clementtttttttt/osprey_dev/README.md

# Osprey_dev

ROM and SIO program for the Osprey Portable Computing Unit

ROM contains a graphical operating system 
SIO contains code for handling commands from the cpu
