clementtttttttt/osprey_dev/kicad/jlcpcb/production_files/BOM-osprey68.csv

Comment | Designator | Footprint | LCSC | Quantity
100n | C11,C12,C13,C14,C15,C16,C5,C6,C7,C8,C9 | C_0603_1608Metric | C14663 | 11
10u | C4 | C_0603_1608Metric | C19702 | 1
10u | C3 | C_0603_1608Metric | C96446 | 1
16Mhz | Y2 | Crystal_SMD_5032-2Pin_5.0x3.2mm_HandSoldering | C112572 | 1
1N4148W | D1 | D_SOD-123 | C81598 | 1
1k | R1,R2,R3,R4 | R_0603_1608Metric | C21190 | 4
22p | C1,C2 | C_0603_1608Metric | C1653 | 2
74HC245D | U4 | SOIC-20W_7.5x12.8mm_P1.27mm | C5625 | 1
74HC74 | U2 | SO-14_3.9x8.65mm_P1.27mm | C41361407 | 1
AMS1117-3.3 | U12 | SOT-223-3_TabPin2 | C6186 | 1
SN74LVC126APWR-TP | U6 | TSSOP-14_4.4x5mm_P0.65mm | C54561942 | 1
8Mhz | Y1 | Oscillator_DIP-8 |  | 1
VIA1 | U15 | DIP-40_W15.24mm_Socket |  | 1
VIA0 | U11 | DIP-40_W15.24mm_Socket |  | 1
ATmega16A-P | U10 | DIP-40_W15.24mm_Socket |  | 1
128k sram | U9 | SOJ-32_7.62x20.955mm_P1.27mm |  | 1
GAL20V8 | U5 | DIP-24_W7.62mm_Socket |  | 1
MC6809E | U1 | DIP-40_W15.24mm_Socket |  | 1
PS2_USB | J1 | USB_A_Molex_67643_Horizontal |  | 1
28C256 | U3 | DIP_Socket-28_W11.9mm_W12.7mm_W15.24mm_W17.78mm_W18.5mm_3M_228-1277-00-0602J |  | 1
Conn_01x08_Pin | J2 | PinHeader_1x08_P2.54mm_Vertical |  | 1
SN74AHCT16245DGGR | U8 | TSSOP-48_6.1x12.5mm_P0.5mm |  | 1
SW_Push | SW1 | PinHeader_1x02_P2.54mm_Vertical |  | 1
SW_SPDT | SW2 | PinHeader_1x03_P2.54mm_Vertical |  | 1
AVR-ISP-6 | J3 | PinHeader_2x03_P2.54mm_Vertical |  | 1
Conn_01x04_Pin | J4 | PinHeader_1x04_P2.54mm_Vertical |  | 1
SD | J6 | PinHeader_1x06_P2.54mm_Vertical |  | 1
LCD | J8 | PinHeader_1x06_P2.54mm_Vertical |  | 1
I2c | J7 | PinHeader_1x05_P2.54mm_Vertical |  | 1
IS62C256AL | U7 | SOP-28_8.4x18.16mm_P1.27mm |  | 1
