clementtttttttt/osprey_dev/kicad/osprey68.kicad_pcb

## KiCad design kicad/osprey68.kicad_pcb (2026-10-19)

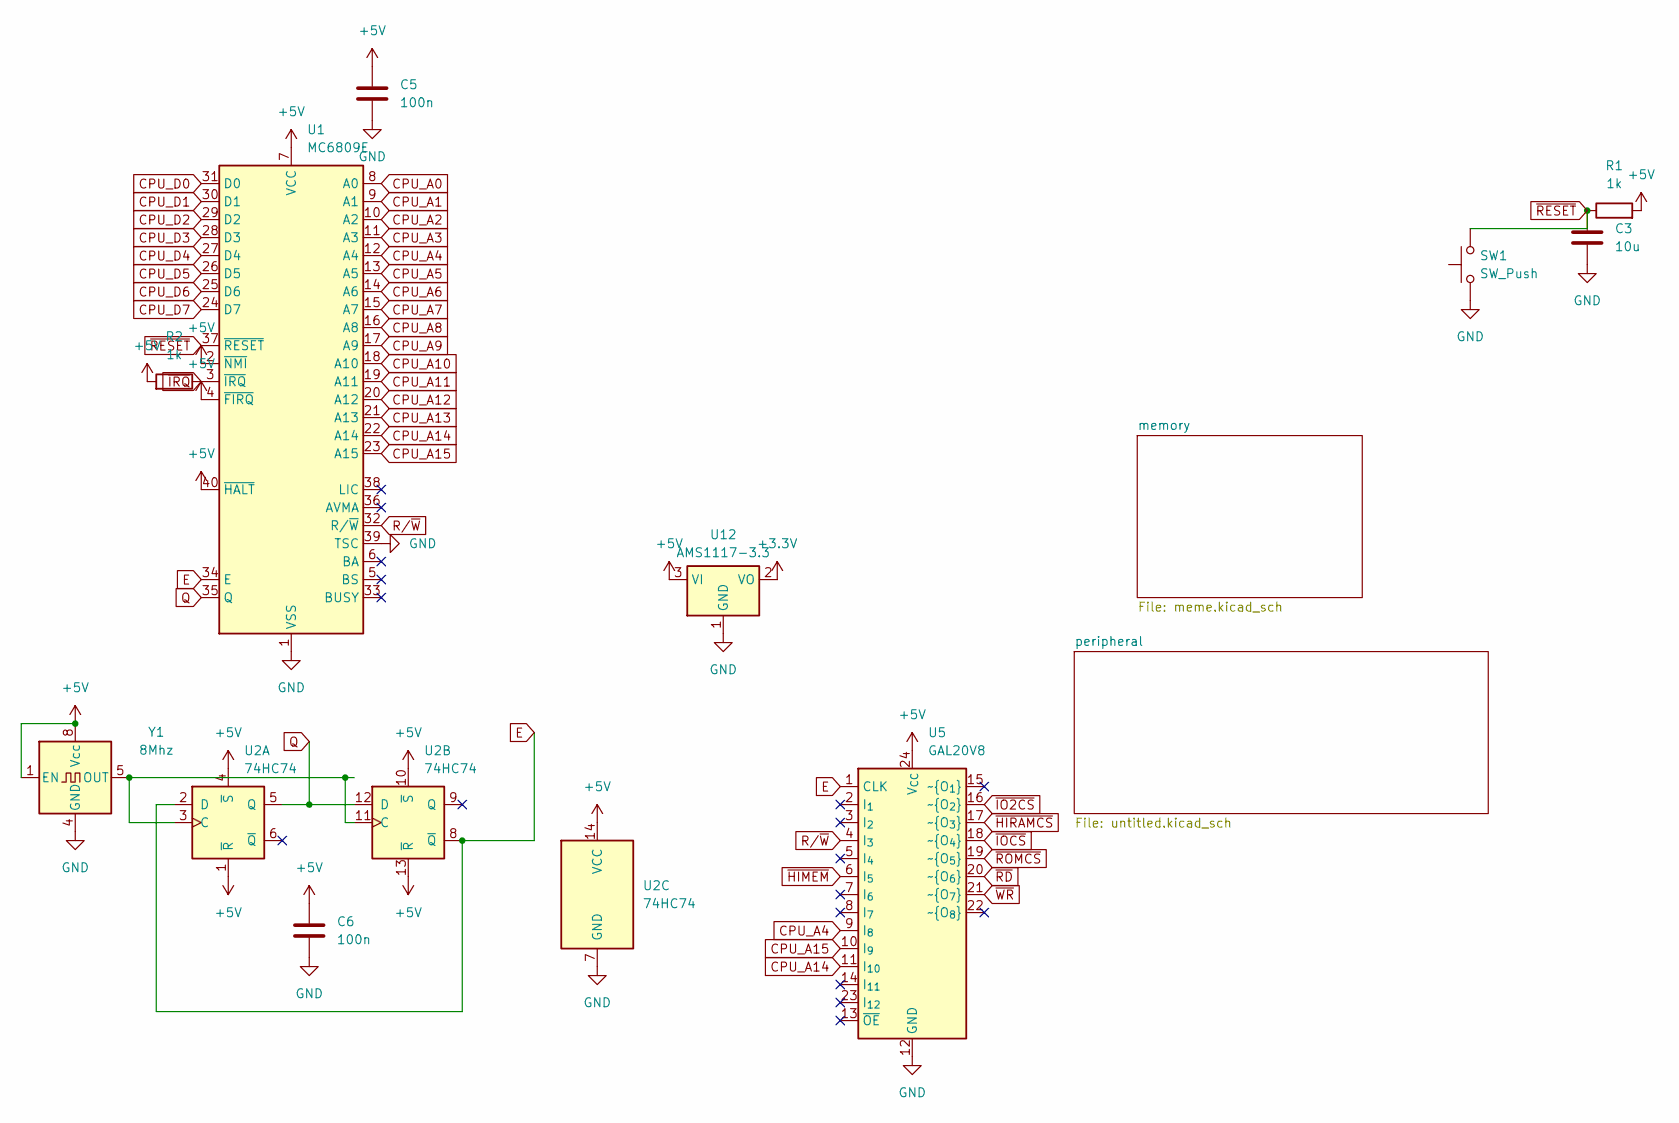
[picture p1: schematic osprey68.kicad_sch]

Parts:
C3: 10u; C_0603_1608Metric
C5, C6: 100n; C_0603_1608Metric
R1, R2: 1k; R_0603_1608Metric
SW1: SW_Push; PinHeader_1x02_P2.54mm_Vertical
U1: MC6809E; DIP-40_W15.24mm_Socket
U2: 74HC74; SO-14_3.9x8.65mm_P1.27mm
U5: GAL20V8; DIP-24_W7.62mm_Socket
U12: AMS1117-3.3; SOT-223-3_TabPin2
Y1: 8Mhz; Oscillator_DIP-8

Connections:
+3.3V: U12.2 (VO); also elsewhere on the board
+5V: C5.1, C6.1, R1.2, R2.2, U1.2 (~NMI), U1.4 (~FIRQ), U1.7 (VCC), U1.40 (~HALT), U2.1 (~R), U2.4 (~S), U2.10 (~S), U2.13 (~R), U2.14 (VCC), U5.24 (V_{CC}), U12.3 (VI), Y1.1 (EN), Y1.8 (Vcc); also elsewhere on the board
CPU_A0: U1.8 (A0); also elsewhere on the board
CPU_A1: U1.9 (A1); also elsewhere on the board
CPU_A2: U1.10 (A2); also elsewhere on the board
CPU_A3: U1.11 (A3); also elsewhere on the board
CPU_A4: U1.12 (A4), U5.9 (I_{8}); also elsewhere on the board
CPU_A5: U1.13 (A5); also elsewhere on the board
CPU_A6: U1.14 (A6); also elsewhere on the board
CPU_A7: U1.15 (A7); also elsewhere on the board
CPU_A8: U1.16 (A8); also elsewhere on the board
CPU_A9: U1.17 (A9); also elsewhere on the board
CPU_A10: U1.18 (A10); also elsewhere on the board
CPU_A11: U1.19 (A11); also elsewhere on the board
CPU_A12: U1.20 (A12); also elsewhere on the board
CPU_A13: U1.21 (A13); also elsewhere on the board
CPU_A14: U1.22 (A14), U5.11 (I_{10}); also elsewhere on the board
CPU_A15: U1.23 (A15), U5.10 (I_{9}); also elsewhere on the board
CPU_D0: U1.31 (D0); also elsewhere on the board
CPU_D1: U1.30 (D1); also elsewhere on the board
CPU_D2: U1.29 (D2); also elsewhere on the board
CPU_D3: U1.28 (D3); also elsewhere on the board
CPU_D4: U1.27 (D4); also elsewhere on the board
CPU_D5: U1.26 (D5); also elsewhere on the board
CPU_D6: U1.25 (D6); also elsewhere on the board
CPU_D7: U1.24 (D7); also elsewhere on the board
E: U1.34 (E), U2.2 (D), U2.8 (~Q), U5.1 (CLK); also elsewhere on the board
GND: C3.2, C5.2, C6.2, SW1.1, U1.1 (VSS), U1.39 (TSC), U2.7 (GND), U5.12 (GND), U12.1 (GND), Y1.4 (GND); also elsewhere on the board
unnamed: U2.3 (C), U2.11 (C), Y1.5 (OUT)
Q: U1.35 (Q), U2.5 (Q), U2.12 (D)
R/~W: U1.32 (R/~W), U5.4 (I_{3}); also elsewhere on the board
~HIMEM: U5.6 (I_{5}); also elsewhere on the board
~HIRAMCS: U5.17 (~O_{3}); also elsewhere on the board
~IO2CS: U5.16 (~O_{2}); also elsewhere on the board
~IOCS: U5.18 (~O_{4}); also elsewhere on the board
~IRQ: R2.1, U1.3 (~IRQ); also elsewhere on the board
~RD: U5.20 (~O_{6}); also elsewhere on the board
~RESET: C3.1, R1.1, SW1.2, U1.37 (~RESET); also elsewhere on the board
~ROMCS: U5.19 (~O_{5}); also elsewhere on the board
~WR: U5.21 (~O_{7}); also elsewhere on the board

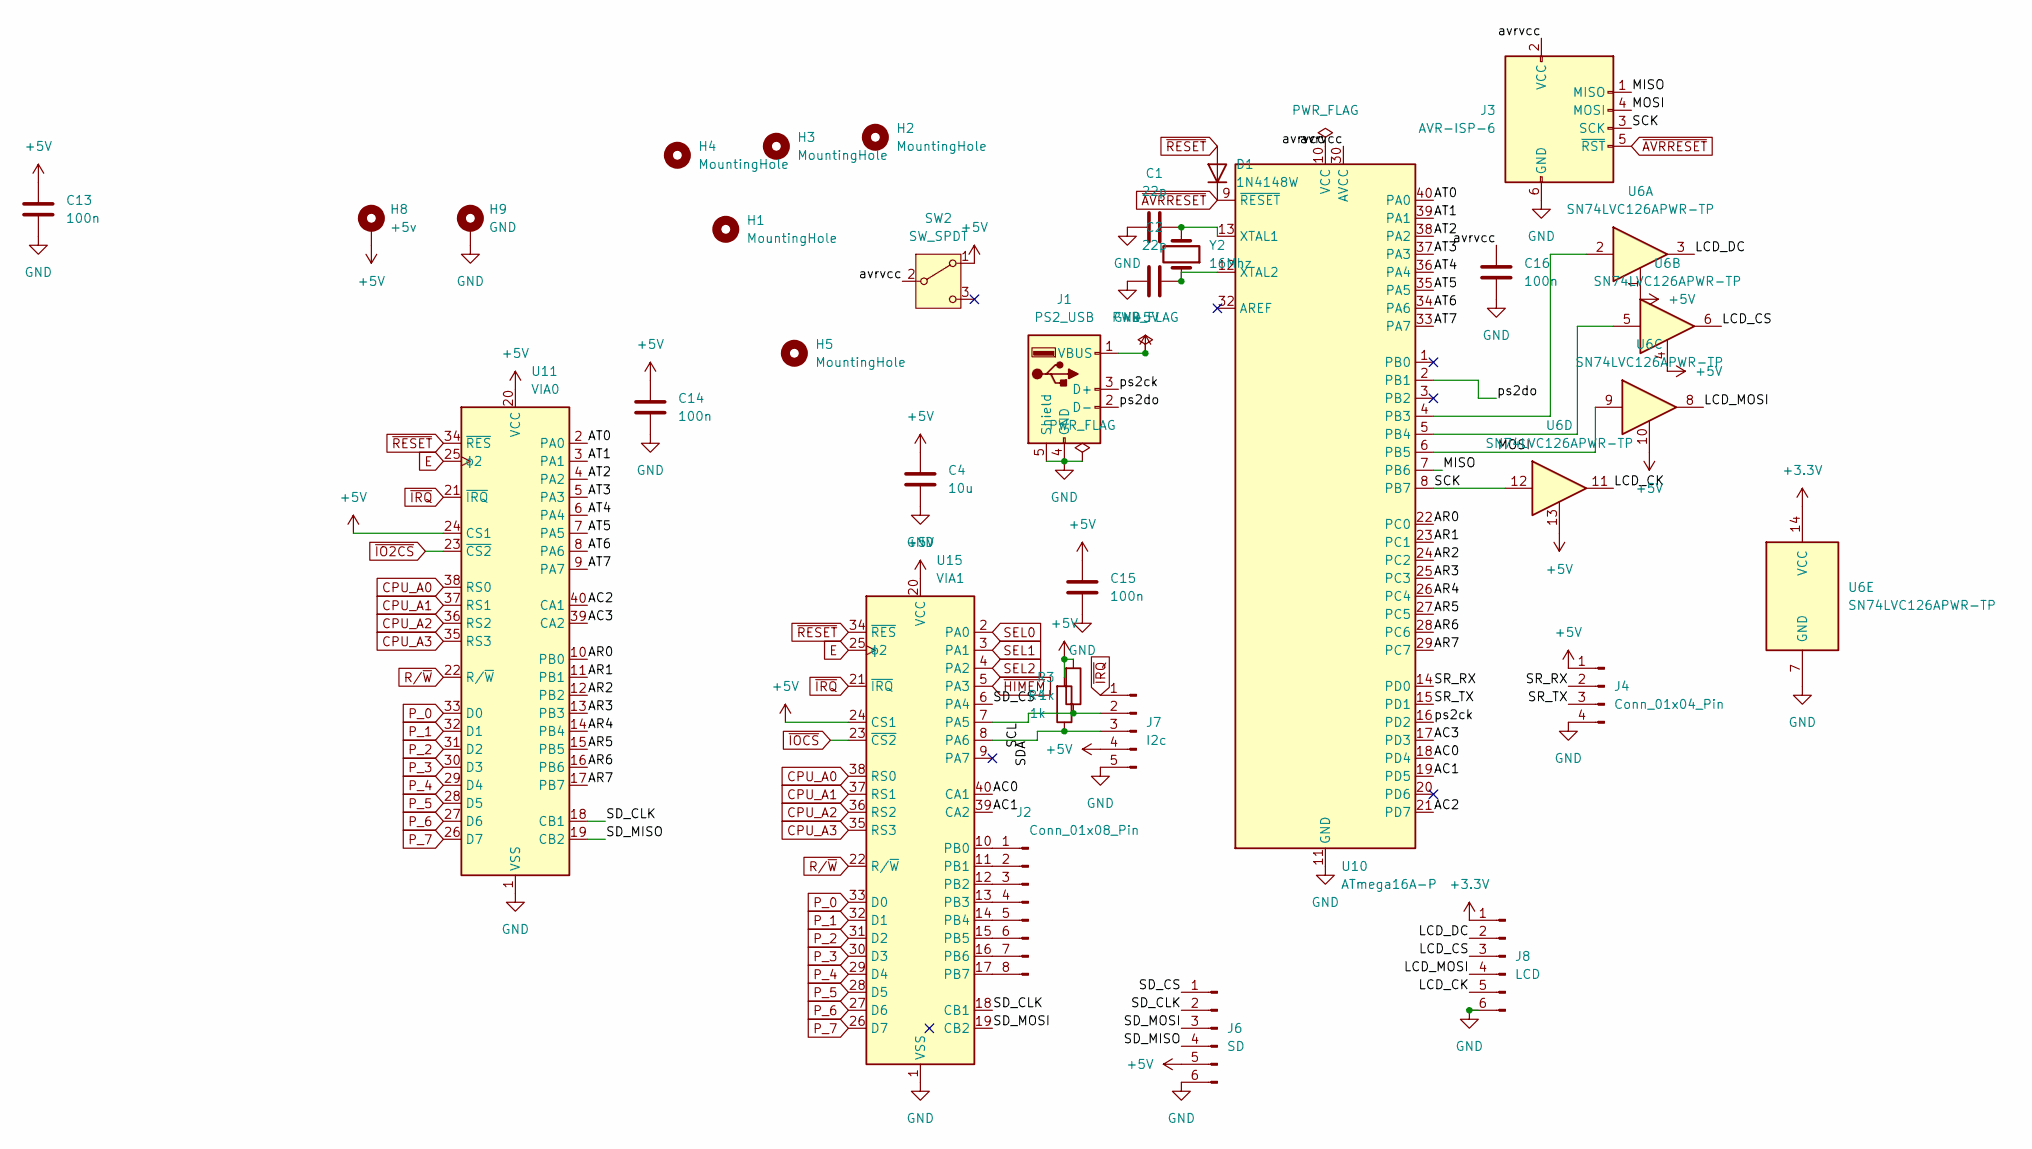
[picture p2: schematic untitled.kicad_sch]

Parts:
C1, C2: 22p; C_0603_1608Metric
C4: 10u; C_0603_1608Metric
C13, C14, C15, C16: 100n; C_0603_1608Metric
D1: 1N4148W; D_SOD-123
H1, H2, H3, H4, H5: MountingHole; MountingHole_3.2mm_M3
H8: +5v; MountingHole_2.5mm_Pad_TopBottom
H9: GND; MountingHole_2.5mm_Pad_TopBottom
J1: PS2_USB; USB_A_Molex_67643_Horizontal
J2: Conn_01x08_Pin; PinHeader_1x08_P2.54mm_Vertical
J3: AVR-ISP-6; PinHeader_2x03_P2.54mm_Vertical
J4: Conn_01x04_Pin; PinHeader_1x04_P2.54mm_Vertical
J6: SD; PinHeader_1x06_P2.54mm_Vertical
J7: I2c; PinHeader_1x05_P2.54mm_Vertical
J8: LCD; PinHeader_1x06_P2.54mm_Vertical
R3, R4: 1k; R_0603_1608Metric
SW2: SW_SPDT; PinHeader_1x03_P2.54mm_Vertical
U6: SN74LVC126APWR-TP; TSSOP-14_4.4x5mm_P0.65mm
U10: ATmega16A-P; DIP-40_W15.24mm_Socket
U11: VIA0; DIP-40_W15.24mm_Socket
U15: VIA1; DIP-40_W15.24mm_Socket
Y2: 16Mhz; Crystal_SMD_5032-2Pin_5.0x3.2mm_HandSoldering

Connections:
+3.3V: J8.1, U6.14 (VCC); also elsewhere on the board
+5V: C4.1, C13.1, C14.1, C15.1, H8.1 (1_1), J1.1 (VBUS), J4.1, J6.5, J7.4, R3.2, R4.2, SW2.1 (A), U6.1, U6.4, U6.10, U6.13, U11.20 (VCC), U11.24 (CS1), U15.20 (VCC), U15.24 (CS1); also elsewhere on the board
/peripheral/AC0: U10.18 (PD4), U15.40 (CA1)
/peripheral/AC1: U10.19 (PD5), U15.39 (CA2)
/peripheral/AC2: U10.21 (PD7), U11.40 (CA1)
/peripheral/AC3: U10.17 (PD3), U11.39 (CA2)
/peripheral/AR0: U10.22 (PC0), U11.10 (PB0)
/peripheral/AR1: U10.23 (PC1), U11.11 (PB1)
/peripheral/AR2: U10.24 (PC2), U11.12 (PB2)
/peripheral/AR3: U10.25 (PC3), U11.13 (PB3)
/peripheral/AR4: U10.26 (PC4), U11.14 (PB4)
/peripheral/AR5: U10.27 (PC5), U11.15 (PB5)
/peripheral/AR6: U10.28 (PC6), U11.16 (PB6)
/peripheral/AR7: U10.29 (PC7), U11.17 (PB7)
/peripheral/AT0: U10.40 (PA0), U11.2 (PA0)
/peripheral/AT1: U10.39 (PA1), U11.3 (PA1)
/peripheral/AT2: U10.38 (PA2), U11.4 (PA2)
/peripheral/AT3: U10.37 (PA3), U11.5 (PA3)
/peripheral/AT4: U10.36 (PA4), U11.6 (PA4)
/peripheral/AT5: U10.35 (PA5), U11.7 (PA5)
/peripheral/AT6: U10.34 (PA6), U11.8 (PA6)
/peripheral/AT7: U10.33 (PA7), U11.9 (PA7)
/peripheral/LCD_CK: J8.5, U6.11
/peripheral/LCD_CS: J8.3, U6.6
/peripheral/LCD_DC: J8.2, U6.3
/peripheral/LCD_MOSI: J8.4, U6.8
/peripheral/MISO: J3.1 (MISO), U10.7 (PB6)
/peripheral/MOSI: J3.4 (MOSI), U6.9, U10.6 (PB5)
/peripheral/SCK: J3.3 (SCK), U6.12, U10.8 (PB7)
/peripheral/SCL: J7.2, R3.1, U15.7 (PA5)
/peripheral/SDA: J7.3, R4.1, U15.8 (PA6)
/peripheral/SD_CLK: J6.2, U11.18 (CB1), U15.18 (CB1)
/peripheral/SD_CS: J6.1, U15.6 (PA4)
/peripheral/SD_MISO: J6.4, U11.19 (CB2)
/peripheral/SD_MOSI: J6.3, U15.19 (CB2)
/peripheral/SR_RX: J4.2, U10.14 (PD0)
/peripheral/SR_TX: J4.3, U10.15 (PD1)
/peripheral/avrvcc: C16.1, J3.2 (VCC), SW2.2 (B), U10.10 (VCC), U10.30 (AVCC)
/peripheral/ps2ck: J1.3 (D+), U10.16 (PD2)
/peripheral/ps2do: J1.2 (D-), U10.2 (PB1)
CPU_A0: U11.38 (RS0), U15.38 (RS0); also elsewhere on the board
CPU_A1: U11.37 (RS1), U15.37 (RS1); also elsewhere on the board
CPU_A2: U11.36 (RS2), U15.36 (RS2); also elsewhere on the board
CPU_A3: U11.35 (RS3), U15.35 (RS3); also elsewhere on the board
E: U11.25 (ϕ2), U15.25 (ϕ2); also elsewhere on the board
GND: C1.1, C2.1, C4.2, C13.2, C14.2, C15.2, C16.2, H9.1 (1_1), J1.4 (GND), J1.5 (Shield), J3.6 (GND), J4.4, J6.6, J7.5, J8.6, U6.7 (GND), U10.11 (GND), U10.31 (GND), U11.1 (VSS), U15.1 (VSS); also elsewhere on the board
unnamed: J2.1, U15.10 (PB0)
unnamed: J2.2, U15.11 (PB1)
unnamed: J2.3, U15.12 (PB2)
unnamed: J2.4, U15.13 (PB3)
unnamed: J2.5, U15.14 (PB4)
unnamed: J2.6, U15.15 (PB5)
unnamed: J2.7, U15.16 (PB6)
unnamed: J2.8, U15.17 (PB7)
unnamed: U6.2, U10.4 (PB3)
unnamed: U6.5, U10.5 (PB4)
unnamed: C1.2, U10.13 (XTAL1), Y2.2
unnamed: C2.2, U10.12 (XTAL2), Y2.1
P_0: U11.33 (D0), U15.33 (D0); also elsewhere on the board
P_1: U11.32 (D1), U15.32 (D1); also elsewhere on the board
P_2: U11.31 (D2), U15.31 (D2); also elsewhere on the board
P_3: U11.30 (D3), U15.30 (D3); also elsewhere on the board
P_4: U11.29 (D4), U15.29 (D4); also elsewhere on the board
P_5: U11.28 (D5), U15.28 (D5); also elsewhere on the board
P_6: U11.27 (D6), U15.27 (D6); also elsewhere on the board
P_7: U11.26 (D7), U15.26 (D7); also elsewhere on the board
R/~W: U11.22 (R/~W), U15.22 (R/~W); also elsewhere on the board
SEL0: U15.2 (PA0); also elsewhere on the board
SEL1: U15.3 (PA1); also elsewhere on the board
SEL2: U15.4 (PA2); also elsewhere on the board
~AVRRESET: D1.1 (K), J3.5 (~RST), U10.9 (~RESET)
~HIMEM: U15.5 (PA3); also elsewhere on the board
~IO2CS: U11.23 (~CS2); also elsewhere on the board
~IOCS: U15.23 (~CS2); also elsewhere on the board
~IRQ: J7.1, U11.21 (~IRQ), U15.21 (~IRQ); also elsewhere on the board
~RESET: D1.2 (A), U11.34 (~RES), U15.34 (~RES); also elsewhere on the board

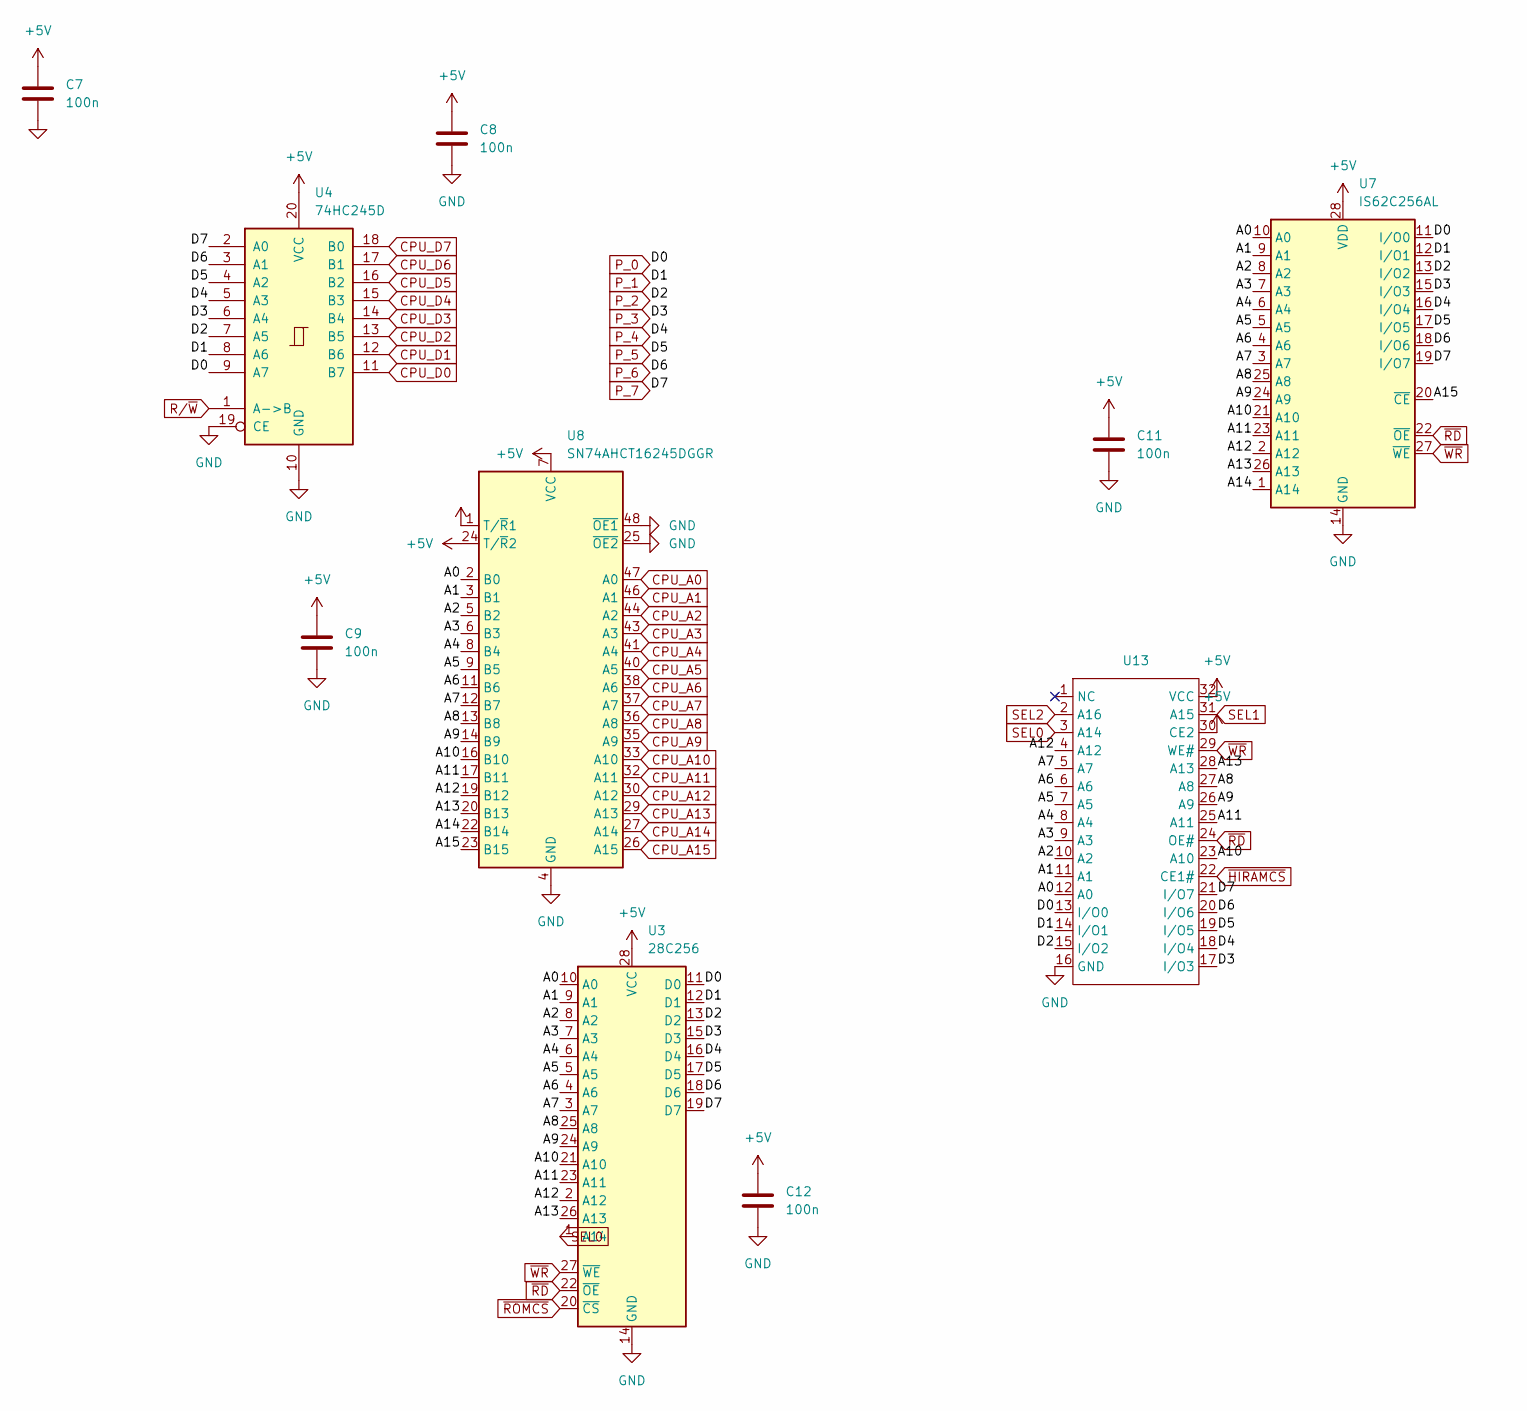
[picture p3: schematic meme.kicad_sch]

Parts:
C7, C8, C9, C11, C12: 100n; C_0603_1608Metric
U3: 28C256; DIP_Socket-28_W11.9mm_W12.7mm_W15.24mm_W17.78mm_W18.5mm_3M_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
U4: 74HC245D; SOIC-20W_7.5x12.8mm_P1.27mm
U7: IS62C256AL; SOP-28_8.4x18.16mm_P1.27mm
U8: SN74AHCT16245DGGR; TSSOP-48_6.1x12.5mm_P0.5mm
U13: SOJ-32_7.62x20.955mm_P1.27mm; Manufacturer Part CY7C1009D-10VXIT; LCSC Part Name CY7C1009D 10VXIT

Connections:
+5V: C7.1, C8.1, C9.1, C11.1, C12.1, U3.28 (VCC), U4.20 (VCC), U7.28 (VDD), U8.1 (T/~R1), U8.7 (VCC), U8.18 (VCC), U8.24 (T/~R2), U8.31 (VCC), U8.42 (VCC), U13.30 (CE2), U13.32 (VCC); also elsewhere on the board
/memory/A0: U3.10 (A0), U7.10 (A0), U8.2 (B0), U13.12 (A0)
/memory/A1: U3.9 (A1), U7.9 (A1), U8.3 (B1), U13.11 (A1)
/memory/A2: U3.8 (A2), U7.8 (A2), U8.5 (B2), U13.10 (A2)
/memory/A3: U3.7 (A3), U7.7 (A3), U8.6 (B3), U13.9 (A3)
/memory/A4: U3.6 (A4), U7.6 (A4), U8.8 (B4), U13.8 (A4)
/memory/A5: U3.5 (A5), U7.5 (A5), U8.9 (B5), U13.7 (A5)
/memory/A6: U3.4 (A6), U7.4 (A6), U8.11 (B6), U13.6 (A6)
/memory/A7: U3.3 (A7), U7.3 (A7), U8.12 (B7), U13.5 (A7)
/memory/A8: U3.25 (A8), U7.25 (A8), U8.13 (B8), U13.27 (A8)
/memory/A9: U3.24 (A9), U7.24 (A9), U8.14 (B9), U13.26 (A9)
/memory/A10: U3.21 (A10), U7.21 (A10), U8.16 (B10), U13.23 (A10)
/memory/A11: U3.23 (A11), U7.23 (A11), U8.17 (B11), U13.25 (A11)
/memory/A12: U3.2 (A12), U7.2 (A12), U8.19 (B12), U13.4 (A12)
/memory/A13: U3.26 (A13), U7.26 (A13), U8.20 (B13), U13.28 (A13)
/memory/A14: U7.1 (A14), U8.22 (B14)
/memory/A15: U7.20 (~CE), U8.23 (B15)
CPU_A0: U8.47 (A0); also elsewhere on the board
CPU_A1: U8.46 (A1); also elsewhere on the board
CPU_A2: U8.44 (A2); also elsewhere on the board
CPU_A3: U8.43 (A3); also elsewhere on the board
CPU_A4: U8.41 (A4); also elsewhere on the board
CPU_A5: U8.40 (A5); also elsewhere on the board
CPU_A6: U8.38 (A6); also elsewhere on the board
CPU_A7: U8.37 (A7); also elsewhere on the board
CPU_A8: U8.36 (A8); also elsewhere on the board
CPU_A9: U8.35 (A9); also elsewhere on the board
CPU_A10: U8.33 (A10); also elsewhere on the board
CPU_A11: U8.32 (A11); also elsewhere on the board
CPU_A12: U8.30 (A12); also elsewhere on the board
CPU_A13: U8.29 (A13); also elsewhere on the board
CPU_A14: U8.27 (A14); also elsewhere on the board
CPU_A15: U8.26 (A15); also elsewhere on the board
CPU_D0: U4.11 (B7); also elsewhere on the board
CPU_D1: U4.12 (B6); also elsewhere on the board
CPU_D2: U4.13 (B5); also elsewhere on the board
CPU_D3: U4.14 (B4); also elsewhere on the board
CPU_D4: U4.15 (B3); also elsewhere on the board
CPU_D5: U4.16 (B2); also elsewhere on the board
CPU_D6: U4.17 (B1); also elsewhere on the board
CPU_D7: U4.18 (B0); also elsewhere on the board
GND: C7.2, C8.2, C9.2, C11.2, C12.2, U3.14 (GND), U4.10 (GND), U4.19 (CE), U7.14 (GND), U8.4 (GND), U8.10 (GND), U8.15 (GND), U8.21 (GND), U8.25 (~OE2), U8.28 (GND), U8.34 (GND), U8.39 (GND), U8.45 (GND), U8.48 (~OE1), U13.16 (GND); also elsewhere on the board
P_0: U3.11 (D0), U4.9 (A7), U7.11 (I/O0), U13.13 (I/O0); also elsewhere on the board
P_1: U3.12 (D1), U4.8 (A6), U7.12 (I/O1), U13.14 (I/O1); also elsewhere on the board
P_2: U3.13 (D2), U4.7 (A5), U7.13 (I/O2), U13.15 (I/O2); also elsewhere on the board
P_3: U3.15 (D3), U4.6 (A4), U7.15 (I/O3), U13.17 (I/O3); also elsewhere on the board
P_4: U3.16 (D4), U4.5 (A3), U7.16 (I/O4), U13.18 (I/O4); also elsewhere on the board
P_5: U3.17 (D5), U4.4 (A2), U7.17 (I/O5), U13.19 (I/O5); also elsewhere on the board
P_6: U3.18 (D6), U4.3 (A1), U7.18 (I/O6), U13.20 (I/O6); also elsewhere on the board
P_7: U3.19 (D7), U4.2 (A0), U7.19 (I/O7), U13.21 (I/O7); also elsewhere on the board
R/~W: U4.1 (A->B); also elsewhere on the board
SEL0: U3.1 (A14), U13.3 (A14); also elsewhere on the board
SEL1: U13.31 (A15); also elsewhere on the board
SEL2: U13.2 (A16); also elsewhere on the board
~HIRAMCS: U13.22 (CE1#); also elsewhere on the board
~RD: U3.22 (~OE), U7.22 (~OE), U13.24 (OE#); also elsewhere on the board
~ROMCS: U3.20 (~CS); also elsewhere on the board
~WR: U3.27 (~WE), U7.27 (~WE), U13.29 (WE#); also elsewhere on the board

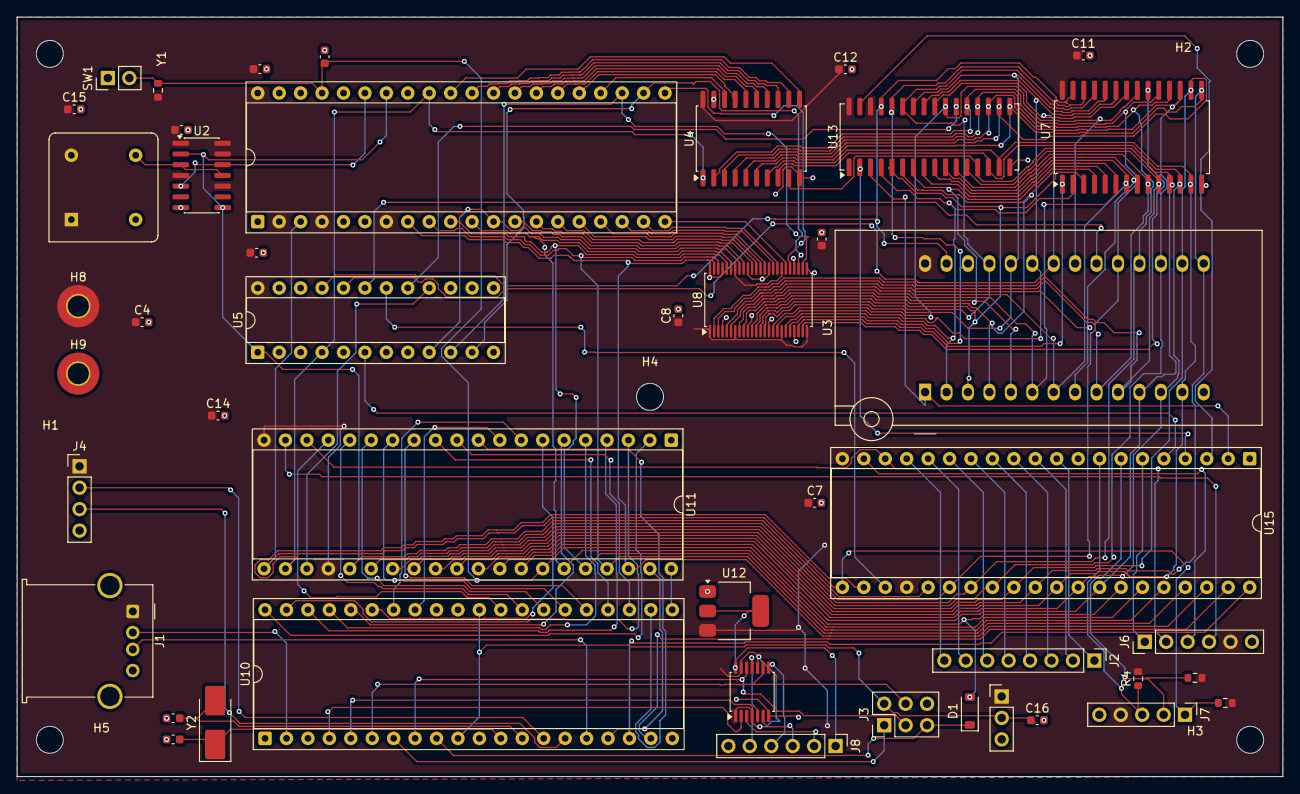
[picture p4: board osprey68.kicad_pcb from above]

Board: 2 copper layers, 150.0 x 90.0 mm, 51 parts (0 on the bottom side), 118 nets.
