clementtttttttt/osprey_dev/sio/osprey_font.h

#define osprey_font_width 8
#define osprey_font_height 1784
const unsigned char osprey_font_bits[] PROGMEM= {
   0x3e, 0x41, 0x55, 0x41, 0x55, 0x49, 0x3e, 0x00, 0x3e, 0x7f, 0x6b, 0x7f,
   0x6b, 0x77, 0x3e, 0x00, 0x36, 0x7f, 0x7f, 0x7f, 0x3e, 0x1c, 0x08, 0x00,
   0x08, 0x1c, 0x3e, 0x7f, 0x3e, 0x1c, 0x08, 0x00, 0x08, 0x1c, 0x2a, 0x7f,
   0x2a, 0x08, 0x3e, 0x00, 0x08, 0x1c, 0x3e, 0x7f, 0x3e, 0x08, 0x3e, 0x00,
   0x00, 0x00, 0x00, 0x08, 0x00, 0x00, 0x00, 0x00, 0x7f, 0x7f, 0x7f, 0x77,
   0x7f, 0x7f, 0x7f, 0x00, 0x00, 0x08, 0x14, 0x14, 0x14, 0x08, 0x00, 0x00,
   0x7f, 0x77, 0x6b, 0x6b, 0x6b, 0x77, 0x7f, 0x00, 0x70, 0x60, 0x52, 0x0d,
   0x05, 0x05, 0x02, 0x00, 0x1c, 0x22, 0x22, 0x1c, 0x08, 0x1c, 0x08, 0x00,
   0x18, 0x28, 0x18, 0x08, 0x08, 0x0c, 0x06, 0x00, 0x7c, 0x44, 0x7c, 0x44,
   0x44, 0x66, 0x33, 0x00, 0x49, 0x2a, 0x1c, 0x77, 0x1c, 0x2a, 0x49, 0x00,
   0x03, 0x0f, 0x3f, 0x7f, 0x3f, 0x0f, 0x03, 0x00, 0x60, 0x78, 0x7e, 0x7f,
   0x7e, 0x78, 0x60, 0x00, 0x08, 0x1c, 0x3e, 0x08, 0x3e, 0x1c, 0x08, 0x00,
   0x36, 0x36, 0x36, 0x36, 0x36, 0x00, 0x36, 0x00, 0x7e, 0x53, 0x5e, 0x50,
   0x50, 0x50, 0x50, 0x00, 0x7e, 0x03, 0x3e, 0x63, 0x3e, 0x60, 0x3f, 0x00,
   0x00, 0x00, 0x00, 0x00, 0x7f, 0x7f, 0x7f, 0x00, 0x08, 0x1c, 0x3e, 0x08,
   0x3e, 0x1c, 0x3e, 0x00, 0x08, 0x1c, 0x3e, 0x08, 0x08, 0x08, 0x08, 0x00,
   0x08, 0x08, 0x08, 0x08, 0x3e, 0x1c, 0x08, 0x00, 0x00, 0x10, 0x30, 0x7f,
   0x30, 0x10, 0x00, 0x00, 0x00, 0x04, 0x06, 0x7f, 0x06, 0x04, 0x00, 0x00,
   0x00, 0x00, 0x01, 0x01, 0x7f, 0x00, 0x00, 0x00, 0x00, 0x14, 0x36, 0x7f,
   0x36, 0x14, 0x00, 0x00, 0x08, 0x1c, 0x1c, 0x3e, 0x3e, 0x7f, 0x7f, 0x00,
   0x7f, 0x7f, 0x3e, 0x3e, 0x1c, 0x1c, 0x08, 0x00, 0x00, 0x00, 0x00, 0x00,
   0x00, 0x00, 0x00, 0x00, 0x0c, 0x0c, 0x0c, 0x0c, 0x0c, 0x00, 0x0c, 0x00,
   0x14, 0x14, 0x00, 0x00, 0x00, 0x00, 0x00, 0x00, 0x36, 0x36, 0x7f, 0x36,
   0x7f, 0x36, 0x36, 0x00, 0x14, 0x7e, 0x15, 0x3e, 0x54, 0x3f, 0x14, 0x00,
   0x43, 0x63, 0x30, 0x18, 0x0c, 0x66, 0x63, 0x00, 0x1e, 0x33, 0x1e, 0x0f,
   0x53, 0x23, 0x5e, 0x00, 0x18, 0x0c, 0x00, 0x00, 0x00, 0x00, 0x00, 0x00,
   0x18, 0x0c, 0x06, 0x06, 0x06, 0x0c, 0x18, 0x00, 0x0c, 0x18, 0x30, 0x30,
   0x30, 0x18, 0x0c, 0x00, 0x00, 0x2d, 0x1e, 0x3f, 0x1e, 0x2d, 0x00, 0x00,
   0x00, 0x0c, 0x0c, 0x3f, 0x0c, 0x0c, 0x00, 0x00, 0x00, 0x00, 0x00, 0x00,
   0x00, 0x18, 0x0c, 0x00, 0x00, 0x00, 0x00, 0x3e, 0x00, 0x00, 0x00, 0x00,
   0x00, 0x00, 0x00, 0x00, 0x00, 0x18, 0x18, 0x00, 0x40, 0x60, 0x30, 0x18,
   0x0c, 0x06, 0x03, 0x00, 0x3e, 0x73, 0x7b, 0x6b, 0x6f, 0x67, 0x3e, 0x00,
   0x08, 0x0e, 0x0c, 0x0c, 0x0c, 0x0c, 0x3f, 0x00, 0x3e, 0x63, 0x60, 0x3c,
   0x06, 0x63, 0x7f, 0x00, 0x3e, 0x63, 0x60, 0x3c, 0x60, 0x63, 0x3e, 0x00,
   0x3c, 0x36, 0x33, 0x7f, 0x30, 0x30, 0x30, 0x00, 0x7f, 0x03, 0x03, 0x3f,
   0x60, 0x63, 0x3e, 0x00, 0x3e, 0x63, 0x03, 0x3f, 0x63, 0x63, 0x3e, 0x00,
   0x7f, 0x60, 0x30, 0x18, 0x0c, 0x0c, 0x0c, 0x00, 0x3e, 0x63, 0x63, 0x3e,
   0x63, 0x63, 0x3e, 0x00, 0x3e, 0x63, 0x63, 0x7e, 0x60, 0x63, 0x3e, 0x00,
   0x00, 0x18, 0x18, 0x00, 0x18, 0x18, 0x00, 0x00, 0x00, 0x18, 0x18, 0x00,
   0x18, 0x18, 0x0c, 0x00, 0x60, 0x38, 0x0e, 0x03, 0x0e, 0x38, 0x60, 0x00,
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
