clementtttttttt/osprey_dev/osprey_emu/include/VIA6522.h

#ifndef VIA6522_H
#define VIA6522_H

#include <simavr/sim_avr.h>

#include <cstdint>
class VIA6522{
	
	uint8_t portb;
	uint8_t porta;
	uint8_t ddrb;
	uint8_t ddra;
	
	uint16_t t1count;
	uint16_t t1latch;
	uint16_t t2count;
	uint16_t t2latch;
	uint8_t sr;
	
	union acr_t{
			uint8_t raw;
			struct{
					uint8_t pa_l_enable:1;
					uint8_t pb_l_enable:1;
					uint8_t sr_modes:3;
					uint8_t t2_modes:1;
					uint8_t t1_modes:1;
			};
	};
	
	acr_t acr;
	uint8_t pcr;
	uint8_t ifr;
	uint8_t ier;
	
	enum IFR_BITS{
		IFR_CA2 = 0b1,
		IFR_CA1 = 0b10,
		IFR_SR  = 0b100,
		IFR_CB2 = 8,
		IFR_CB1 = 16,
		IFR_T2 = 32,
		IFR_T1 = 64
	};
	

	enum REG6522_R{
			IRBR,
			IRAR,
			DDRBR,
			DDRAR,
			T1_COUNT_LR,
			T1_COUNT_HR,
			T1_LATCH_LR,
			T1_LATCH_HR,
			T2_COUNT_LR,
			T2_COUNT_HR,
			SRR,
			ACRR,
			PCRR,
			IFRR,
			IERR,
			IRA_NOHSR
		
	};
	
	enum PCR_CX_MODES{
		CX2_NEG_SF_RW_CLR = 0,
		CX2_NEG_SF_RW_NOCLR,
		CX2_POS_SF_RW_CLR,
		CX2_POS_SF_RW_NOCLR,
		CX2_LOW_ON_RW_HIGH_ON_CX1,
		CX2_LOW_PULSE_ON_RW,
		CX2_LOW,
		CX2_HIGH
		
	};

	enum REG6522_W{
		ORBW,
		ORAW,
		DDRBW,
		DDRAW,
		T1_LATCH_LW,
		T1_COUNT_HW,
		T1_LATCH_L2W,
		T1_LATCH_HW,
		T2_LATCH_LW,
		T2_COUNT_HW,
		SRW,
		ACRW,
		PCRW,
		IFRW,
		IERW,
		ORA_NOHSW
	
	};
	
	bool cb2;
	bool ca2;
	bool ca1;
	bool cb1;
	void (*cb2_w_cb)(bool st);
	void (*ca2_w_cb)(bool st);

	void (*pb_w_cb)(uint8_t st);
	
	void (*on_irq_cb)();

	enum ACR_T1_MODES{
		T1_OS = 0,
		T1_FR,
		T1_OS_PB7,
		T1_FR_PB7
	};
	
	enum ACR_SR_MODES{
		SR_DISABLED=0,
		SR_SHIFT_IN_CLK_T2,
		SR_SHIFT_IN_CLK_PHI2,
		SR_SHIFT_IN_CLK_CB1,
		SR_SHIFT_IN_CLK_T2_NOSTOPAFTER8_NOINT,
		SR_SHIFT_OUT_CLK_T2,
		SR_SHIFT_OUT_CLK_PHI2,
		SR_SHIFT_OUT_CLK_CB1	
	};
	void fire_irq(uint8_t in);
	
	int ca2_low_counter;

public:

	

	void phi2_tick();
	
	void reg_write(uint16_t addr, uint8_t data);
	VIA6522();
	uint8_t reg_read(uint16_t addr);
	void ext_write_portb(uint8_t active_bits, uint8_t data);
	void ext_write_porta(uint8_t active_bits, uint8_t data);
	
	void ext_set_ca1(uint32_t v);
	
	void reset();
	
	uint8_t ext_get_sr();
	
	void on_cb2_w(bool st);
	void on_ca2_w(bool st);
	
	void on_pb_w(uint8_t in);
	
	void set_cb2_w_cb(void(*)(bool));
	void set_ca2_w_cb(void(*)(bool));

	void set_pb_w_cb(void(*)(uint8_t));
	void set_on_irq_cb(void(*)());
};

#endif
