clementtttttttt/osprey_dev/sio/conf.h

#define PS2_PORT PORTB
#define PS2_PIN PINB
#define PS2_DDR DDRB
#define PS2_PCINT PCINT8
#define PS2_PCINT_vect PCINT1_vect
#define PS2_PIN_CLOCK PD2
#define PS2_PIN_DATA PB1
#define PS2_SHIFT_DEFAULT 0 /* if set, activate shift mode by default */
#define PS2_DEBUG 0 /* if set, store scan-code in buffer instead of ascii code */
