clementtttttttt/osprey_dev/sio/ili9488.h

#define ILI9488_TFTWIDTH  320
#define ILI9488_TFTHEIGHT 480

#define ILI9488_NOP     0x00
#define ILI9488_SWRESET 0x01
#define ILI9488_RDDID   0x04
#define ILI9488_RDDST   0x09

#define ILI9488_SLPIN   0x10
#define ILI9488_SLPOUT  0x11
#define ILI9488_PTLON   0x12
#define ILI9488_NORON   0x13

#define ILI9488_RDMODE  0x0A
#define ILI9488_RDMADCTL  0x0B
#define ILI9488_RDPIXFMT  0x0C
#define ILI9488_RDIMGFMT  0x0D
#define ILI9488_RDSELFDIAG  0x0F

#define ILI9488_INVOFF  0x20
#define ILI9488_INVON   0x21
#define ILI9488_GAMMASET 0x26
#define ILI9488_DISPOFF 0x28
#define ILI9488_DISPON  0x29

#define ILI9488_CASET   0x2A
#define ILI9488_PASET   0x2B
#define ILI9488_RAMWR   0x2C
#define ILI9488_RAMRD   0x2E

#define ILI9488_PTLAR   0x30
#define ILI9488_MADCTL  0x36
#define ILI9488_PIXFMT  0x3A

#define ILI9488_VSCRDEF 0x33
#define ILI9488_VSCRSADD 0x37

// Color definitions
#define ILI9488_BLACK       0x0000      /*   0,   0,   0 */
#define ILI9488_NAVY        0x000F      /*   0,   0, 128 */
#define ILI9488_DARKGREEN   0x03E0      /*   0, 128,   0 */
#define ILI9488_DARKCYAN    0x03EF      /*   0, 128, 128 */
#define ILI9488_MAROON      0x7800      /* 128,   0,   0 */
#define ILI9488_PURPLE      0x780F      /* 128,   0, 128 */
#define ILI9488_OLIVE       0x7BE0      /* 128, 128,   0 */
#define ILI9488_LIGHTGREY   0xC618      /* 192, 192, 192 */
#define ILI9488_DARKGREY    0x7BEF      /* 128, 128, 128 */
#define ILI9488_BLUE        0x001F      /*   0,   0, 255 */
#define ILI9488_GREEN       0x07E0      /*   0, 255,   0 */
#define ILI9488_CYAN        0x07FF      /*   0, 255, 255 */
#define ILI9488_RED         0xF800      /* 255,   0,   0 */
#define ILI9488_MAGENTA     0xF81F      /* 255,   0, 255 */
#define ILI9488_YELLOW      0xFFE0      /* 255, 255,   0 */
#define ILI9488_WHITE       0xFFFF      /* 255, 255, 255 */
#define ILI9488_ORANGE      0xFD20      /* 255, 165,   0 */
#define ILI9488_GREENYELLOW 0xAFE5      /* 173, 255,  47 */
#define ILI9488_PINK        0xF81F
