clementtttttttt/osprey_dev/(commit log)

2025-08-22 gui framework: added toolbar and menu
2025-10-04 implemented 6522 timer setup and interrupts
2026-05-03 add kicad porject
    [BOM-osprey68.csv, logicshift.kicad_sch, meme.kicad_sch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]
2026-05-06 add spi hook, add 6522 io hook
2026-05-06 fix sd_wait_spi inverted branch, implement ifr reading in 6522
    [CPU6809.cpp, VIA6522.cpp, VIA6522.h, main.cpp]
2026-05-07 connect 6522 to simavr
    [untitled.kicad_sch]
2026-05-08 scale window to 2x, add hardware interrupt to CPU6809
2026-05-08 add stdio to uart output
2026-05-08 input values sent correctly
    [VIA6522.cpp, main.cpp]
2026-05-09 fixed rol bug and added memory inspector, wozmon fully functional
    [CPU6809.cpp, CPU6809.h, main.cpp]
2026-05-10 fix multi gui menu drawing
    [CPU6809.cpp, main.cpp]
2026-05-10 add missing 6522 reg read code
    [VIA6522.cpp]
2026-05-10 properly add vsync to limit framerate, add t2 reg write cases
2026-05-10 add good error message for rom and sio reading errors
    [main.cpp]
